CCYD/8bbbc/KiCad project/8bit-computer/8bit-computer.kicad_pcb

## KiCad design KiCad project/8bit-computer/8bit-computer.kicad_pcb (2024-12-27)

Schematic: 8bit-computer.kicad_sch

Parts:
C1, C3, C5, C6, C7, C8, C9, C10, C11, C12, C13, C14, C15, C16, C17, C18, C19, C20, C21, C22, C23, C24, C25, C26, C27, C28, C29, C30, C31, C32, C33, C34, C35, C36, C37, C38, C39, C40, C41, C42, C43, C44, C45, C46, C47, C48, C51, C52, C53, C54, C55, C56, C57, C60, C61, C63, C64, C65, C66, C67, C68, C69, C70: 0.1uF; C_Disc_D5.0mm_W2.5mm_P5.00mm
C2, C4: 1uF; C_Disc_D5.0mm_W2.5mm_P5.00mm
C49, C50: .01u; C_Disc_D5.0mm_W2.5mm_P5.00mm
C58, C59: 4.7u; CP_Radial_D8.0mm_P2.50mm
C62: 1u; C_Disc_D5.0mm_W2.5mm_P5.00mm
D1, D2, D3, D4, D7, D8, D9, D10, D11, D12, D13, D14, D17, D18, D19, D20, D21, D22, D23, D24, D25, D29, D30, D31, D32, D33, D34, D35, D36, D37, D39, D40, D41, D42, D43, D44, D45, D46, D47, D48, D49, D50, D51, D52, D53, D54, D55, D56, D57, D58, D59, D60, D61, D62, D63, D64, D69, D70, D71, D72, D73, D74, D75, D76, D77, D78, D79, D80, D81, D82, D83, D84, D85, D86, D87, D88, D89, D90, D91, D92, D93: LED; LED_D5.0mm
D5: Green; LED_D5.0mm
D6: Red; LED_D5.0mm
D15: 5817; D_A-405_P7.62mm_Horizontal
D16, D65, D66, D67, D68: Yellow; LED_D5.0mm
D26, D27, D28, D38: LED; LED_D5.0mm; not fitted
H1, H2, H3, H4, H5, H6: MountingHole_Pad; MountingHole_2.7mm_M2.5_DIN965_Pad
IC1, IC2, IC3: AT28C16-15PI; DIP1550W56P254L3190H559Q24N; Mouser Part Number 556-AT28C16-15PI
J1: USB_C_Receptacle_PowerOnly_6P; USB_C_Receptacle_GCT_USB4085
JP1: Jumper_2_Open; PinHeader_1x02_P2.54mm_Vertical
R1, R5, R10, R31, R33, R36, R37, R59, R60, R61, R62, R63, R64, R65, R66, R85, R89, R90, R91, R95, R96: 1K; R_Axial_DIN0207_L6.3mm_D2.5mm_P10.16mm_Horizontal
R2, R3, R4, R9, R16, R17, R35: 10K; R_Axial_DIN0207_L6.3mm_D2.5mm_P10.16mm_Horizontal
R6: 470K; R_Axial_DIN0207_L6.3mm_D2.5mm_P10.16mm_Horizontal
R7, R8: 1M; R_Axial_DIN0207_L6.3mm_D2.5mm_P10.16mm_Horizontal
R15: 120R; R_Axial_DIN0207_L6.3mm_D2.5mm_P10.16mm_Horizontal
R18, R32, R94: R_Axial_DIN0207_L6.3mm_D2.5mm_P10.16mm_Horizontal
R34: R_US; R_Axial_DIN0207_L6.3mm_D2.5mm_P10.16mm_Horizontal
R50: 1K; R_Axial_DIN0207_L6.3mm_D2.5mm_P10.16mm_Horizontal; not fitted
R88: 20K; R_Axial_DIN0207_L6.3mm_D2.5mm_P10.16mm_Horizontal
R92, R93: 5.1K; R_Axial_DIN0207_L6.3mm_D2.5mm_P10.16mm_Horizontal
RN1, RN2, RN3, RN4, RN5, RN6, RN7, RN8, RN9, RN10, RN11: R_Network08_US; R_Array_SIP9
RN12, RN13, RN14, RN15: R_Network04_US; R_Array_SIP5
RV1: 1M; Potentiometer_Alpha_RD901F-40-00D_Single_Vertical_CircularH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
SW1, SW6, SW7: SW_Push; SW_PUSH-12mm
SW2: SW_DIP_x08; DIP-16_W7.62mm_LongPads
SW3: SW_DIP_x04; DIP-8_W7.62mm_LongPads
SW4, SW5, SW9: SW_DPDT_x2_Mine; SW_Push_2P2T_Toggle_CK_PVA2xxH1xxxxxxV2
U1, U2, U3, U52: NE555P; DIP-8_W7.62mm_Socket_LongPads
U4, U12, U13, U30, U31: 74LS04; DIP-14_W7.62mm_Socket_LongPads
U5, U45, U56: 74LS08; DIP-14_W7.62mm_Socket_LongPads
U6: 74LS32; DIP-14_W7.62mm_Socket_LongPads
U7, U25, U26, U35, U36, U37, U39, U46, U57, U58: 74LS173; DIP-16_W7.62mm_Socket_LongPads
U8, U9, U15, U16, U17, U18, U19: 74LS157; DIP-16_W7.62mm_Socket_LongPads
U10, U11: 74F189PC; DIP-16_W7.62mm_Socket_LongPads
U14, U27, U32, U34, U38, U47: 74LS245; DIP-20_W7.62mm_Socket_LongPads
U20, U21: 74LS595; DIP-16_W7.62mm_Socket_LongPads
U22: NodeMCU_v1.0
U23, U24: 74LS00; DIP-14_W7.62mm_Socket_LongPads
U28, U33: 74LS161; DIP-16_W7.62mm_Socket_LongPads
U29: 74LS138; DIP-16_W7.62mm_Socket_LongPads
U40, U41: 74LS283; DIP-16_W7.62mm_Socket_LongPads
U42, U43: 74LS86; DIP-14_W7.62mm_Socket_LongPads
U44: 74LS02; DIP-14_W7.62mm_Socket_LongPads
U48, U49, U50, U51: D168K; D1X8K
U53: 74LS107; DIP-14_W7.62mm_Socket_LongPads
U55: 74LS139; DIP-16_W7.62mm_Socket_LongPads

Connections:
/A: IC3.16 (I/O6), U48.7 (A), U49.7 (A), U50.7 (A), U51.7 (A)
/A0: D26.2 (A), IC1.8 (A0), IC2.8 (A0), U28.14 (Q0), U29.1 (A0)
/A1: D27.2 (A), IC1.7 (A1), IC2.7 (A1), U28.13 (Q1), U29.2 (A1)
/A2: D28.2 (A), IC1.6 (A2), IC2.6 (A2), U28.12 (Q2), U29.3 (A2)
/A4: D22.2 (A), IC1.5 (A3), IC2.5 (A3), U25.3 (Q0)
/A5: D23.2 (A), IC1.4 (A4), IC2.4 (A4), U25.4 (Q1)
/A6: D24.2 (A), IC1.3 (A5), IC2.3 (A5), U25.5 (Q2)
/A7: D25.2 (A), IC1.2 (A6), IC2.2 (A6), U25.6 (Q3)
/B: IC3.15 (I/O5), U48.6 (B), U49.6 (B), U50.6 (B), U51.6 (B)
/BUS_0: D70.2 (A), RN2.2 (R1), U7.14 (D0), U14.18 (B0), U18.2 (I0a), U26.14 (D0), U27.18 (B0), U32.2 (A0), U33.3 (D0), U34.18 (B0), U35.14 (D0), U37.14 (D0), U38.18 (B0), U47.18 (B0), U58.14 (D0)
/BUS_1: D71.2 (A), RN2.3 (R2), U7.13 (D1), U14.17 (B1), U18.5 (I0b), U26.13 (D1), U27.17 (B1), U32.3 (A1), U33.4 (D1), U34.17 (B1), U35.13 (D1), U37.13 (D1), U38.17 (B1), U47.17 (B1), U58.13 (D1)
/BUS_2: D72.2 (A), RN2.4 (R3), U7.12 (D2), U14.16 (B2), U18.11 (I0c), U26.12 (D2), U27.16 (B2), U32.4 (A2), U33.5 (D2), U34.16 (B2), U35.12 (D2), U37.12 (D2), U38.16 (B2), U47.16 (B2), U58.12 (D2)
/BUS_3: D73.2 (A), RN2.5 (R4), U7.11 (D3), U14.15 (B3), U18.14 (I0d), U26.11 (D3), U27.15 (B3), U32.5 (A3), U33.6 (D3), U34.15 (B3), U35.11 (D3), U37.11 (D3), U38.15 (B3), U47.15 (B3), U58.11 (D3)
/BUS_4: D74.2 (A), RN2.6 (R5), U14.14 (B4), U19.2 (I0a), U25.14 (D0), U27.14 (B4), U34.14 (B4), U36.14 (D0), U38.14 (B4), U39.14 (D0), U47.14 (B4), U57.14 (D0)
/BUS_5: D75.2 (A), RN2.7 (R6), U14.13 (B5), U19.5 (I0b), U25.13 (D1), U27.13 (B5), U34.13 (B5), U36.13 (D1), U38.13 (B5), U39.13 (D1), U47.13 (B5), U57.13 (D1)
/BUS_6: D76.2 (A), RN2.8 (R7), U14.12 (B6), U19.11 (I0c), U25.12 (D2), U27.12 (B6), U34.12 (B6), U36.12 (D2), U38.12 (B6), U39.12 (D2), U47.12 (B6), U57.12 (D2)
/BUS_7: D77.2 (A), RN2.9 (R8), U14.11 (B7), U19.14 (I0d), U25.11 (D3), U27.11 (B7), U34.11 (B7), U36.11 (D3), U38.11 (B7), U39.11 (D3), U47.11 (B7), U57.11 (D3)
/C: IC3.14 (I/O4), U48.4 (C), U49.4 (C), U50.4 (C), U51.4 (C)
/CARRY: U41.9 (C4), U46.14 (D0)
/D: IC3.13 (I/O3), U48.2 (D), U49.2 (D), U50.2 (D), U51.2 (D)
/DP: IC3.17 (I/O7), U48.5 (DP), U49.5 (DP), U50.5 (DP), U51.5 (DP)
/E: IC3.11 (I/O2), U48.1 (E), U49.1 (E), U50.1 (E), U51.1 (E)
/F: IC3.9 (I/O0), U48.9 (F), U49.9 (F), U50.9 (F), U51.9 (F)
/G: IC3.10 (I/O1), U48.10 (G), U49.10 (G), U50.10 (G), U51.10 (G)
/IR_A0: D18.2 (A), U26.3 (Q0), U27.2 (A0)
/IR_A1: D19.2 (A), U26.4 (Q1), U27.3 (A1)
/IR_A2: D20.2 (A), U26.5 (Q2), U27.4 (A2)
/IR_A3: D21.2 (A), U26.6 (Q3), U27.5 (A3)
/ZERO: U45.8, U46.13 (D1)
/a0: D65.2 (A), RN13.3 (R2), U9.4 (Za), U10.1 (A0), U11.1 (A0)
/a1: D66.2 (A), RN13.2 (R1), U9.7 (Zb), U10.15 (A1), U11.15 (A1)
/a2: D67.2 (A), RN13.5 (R4), U9.9 (Zc), U10.14 (A2), U11.14 (A2)
/a3: D68.2 (A), RN13.4 (R3), U9.12 (Zd), U10.13 (A3), U11.13 (A3)
/a_d0: D49.2 (A), U34.2 (A0), U35.3 (Q0), U40.5 (A1)
/a_d1: D50.2 (A), U34.3 (A1), U35.4 (Q1), U40.3 (A2)
/a_d2: D51.2 (A), U34.4 (A2), U35.5 (Q2), U40.14 (A3)
/a_d3: D52.2 (A), U34.5 (A3), U35.6 (Q3), U40.12 (A4)
/a_d4: D53.2 (A), U34.6 (A4), U36.3 (Q0), U41.5 (A1)
/a_d5: D54.2 (A), U34.7 (A5), U36.4 (Q1), U41.3 (A2)
/a_d6: D55.2 (A), U34.8 (A6), U36.5 (Q2), U41.14 (A3)
/a_d7: D56.2 (A), U34.9 (A7), U36.6 (Q3), U41.12 (A4)
/b_d0: D57.2 (A), U37.3 (Q0), U38.2 (A0), U42.2
/b_d1: D58.2 (A), U37.4 (Q1), U38.3 (A1), U42.5
/b_d2: D59.2 (A), U37.5 (Q2), U38.4 (A2), U42.10
/b_d3: D60.2 (A), U37.6 (Q3), U38.5 (A3), U42.13
/b_d4: D61.2 (A), U38.6 (A4), U39.3 (Q0), U43.2
/b_d5: D62.2 (A), U38.7 (A5), U39.4 (Q1), U43.5
/b_d6: D63.2 (A), U38.8 (A6), U39.5 (Q2), U43.10
/b_d7: D64.2 (A), U38.9 (A7), U39.6 (Q3), U43.13
/d0: U10.4 (D0), U16.4 (Za)
/d1: U10.6 (D1), U16.7 (Zb)
/d2: U10.10 (D2), U16.9 (Zc)
/d3: U10.12 (D3), U16.12 (Zd)
/d4: U11.4 (D0), U17.4 (Za)
/d5: U11.6 (D1), U17.7 (Zb)
/d6: U11.10 (D2), U17.9 (Zc)
/d7: U11.12 (D3), U17.12 (Zd)
ARD_HALT: R10.2, U6.4, U22.20 (D8)
ARD_MAR_INP_SEL: R31.2, U9.1 (S), U22.22 (D6)
ARD_MA_A0: U9.3 (I1a), U21.3 (QD)
ARD_MA_A1: U9.6 (I1b), U21.2 (QC)
ARD_MA_A2: U9.10 (I1c), U21.1 (QB)
ARD_MA_A3: U9.13 (I1d), U21.15 (QA)
ARD_RAM_D0: U16.3 (I1a), U20.7 (QH)
ARD_RAM_D1: U16.6 (I1b), U20.6 (QG)
ARD_RAM_D2: U16.10 (I1c), U20.5 (QF)
ARD_RAM_D3: U16.13 (I1d), U20.4 (QE)
ARD_RAM_D4: U17.3 (I1a), U20.3 (QD)
ARD_RAM_D5: U17.6 (I1b), U20.2 (QC)
ARD_RAM_D6: U17.10 (I1c), U20.1 (QB)
ARD_RAM_D7: U17.13 (I1d), U20.15 (QA)
ARD_RAM_INP_SEL: D16.2 (A), R34.2, U16.1 (S), U17.1 (S), U22.21 (D7)
ARD_RAM_WR_EN: R18.1, U10.3 (*WE), U11.3 (*WE), U15.12 (Zd), U22.27 (D3)
ARD_RESET: R36.1, SW7.2, U22.23 (D5), U23.12, U23.13
CLK: D4.2 (A), U4.13, U5.8, U7.7 (Cp), U24.12, U24.13, U25.7 (Cp), U26.7 (Cp), U33.2 (CP), U35.7 (Cp), U36.7 (Cp), U37.7 (Cp), U39.7 (Cp), U46.7 (Cp), U56.1
GND: C1.2, C2.2, C3.2, C4.2, C5.2, C6.2, C7.1, C8.1, C9.1, C10.1, C11.1, C12.1, C13.1, C14.1, C15.1, C16.1, C17.1, C18.1, C19.1, C21.1, C22.1, C23.1, C24.1, C25.1, C26.1, C27.1, C28.1, C29.1, C30.1, C31.1, C32.2, C33.2, C34.1, C35.1, C36.1, C37.1, C38.1, C39.1, C40.1, C41.1, C42.1, C43.1, C44.1, C45.1, C46.1, C47.1, C48.1, C49.2, C50.2, C51.1, C52.2, C53.2, C54.1, C55.1, C56.1, C57.2, C58.2, C59.2, C60.1, C61.2, C62.2, C63.1, C64.1, C65.1, C66.1, C67.1, C68.1, C69.1, C70.1, H1.1, H2.1, H3.1, H4.1, H5.1, H6.1, IC1.1 (A7), IC1.12 (GND), IC1.18 (~CE), IC1.19 (A10), IC1.20 (~OE), IC2.12 (GND), IC2.18 (~CE), IC2.19 (A10), IC2.20 (~OE), IC3.12 (GND), IC3.18 (~CE), IC3.20 (~OE), J1.A12 (GND), J1.B12 (GND), J1.S1 (SHIELD), R2.2, R3.2, R4.1, R9.2, R10.1, R31.1, R33.2, R34.1, R35.2, R36.2, R37.2, R50.2, R65.2, R66.2, R89.2, R92.1, R93.1, R94.1, R95.2, RN2.1 (common), RN3.1 (common), RN4.1 (common), RN5.1 (common), RN6.1 (common), RN7.1 (common), RN8.1 (common), RN9.1 (common), RN10.1 (common), RN11.1 (common), RN13.1 (common), RN14.1 (common), RN15.1 (common), RV1.MP (MountPin), SW1.1, SW2.1, SW2.2, SW2.3, SW2.4, SW2.5, SW2.6, SW2.7, SW2.8, SW3.1, SW3.2, SW3.3, SW3.4, SW4.1 (A), SW5.1 (A), SW6.1, SW9.2 (C), U1.1 (GND), U2.1 (GND), U3.1 (GND), U3.6 (THR), U4.7 (GND), U5.7 (GND), U6.7 (GND), U7.1 (Oe1), U7.2 (Oe2), U7.8 (GND), U8.8 (GND), U8.15 (E), U9.8 (GND), U9.15 (E), U10.2 (*CS), U10.8 (GND), U11.2 (*CS), U11.8 (GND), U12.7 (GND), U13.7 (GND), U14.10 (GND), U15.8 (GND), U15.15 (E), U16.8 (GND), U16.15 (E), U17.8 (GND), U17.15 (E), U18.8 (GND), U18.15 (E), U19.8 (GND), U19.15 (E), U20.8 (GND), U21.8 (GND), U22.10 (GND), U22.14 (GND), U22.17 (GND), U22.24 (GND), U23.7 (GND), U24.7 (GND), U25.1 (Oe1), U25.2 (Oe2), U25.8 (GND), U26.1 (Oe1), U26.2 (Oe2), U26.8 (GND), U27.6 (A4), U27.7 (A5), U27.8 (A6), U27.9 (A7), U27.10 (GND), U28.8 (GND), U29.4 (E1), U29.5 (E2), U29.8 (GND), U30.7 (GND), U31.7 (GND), U32.1 (A->B), U32.10 (GND), U33.8 (GND), U34.10 (GND), U35.1 (Oe1), U35.2 (Oe2), U35.8 (GND), U36.1 (Oe1), U36.2 (Oe2), U36.8 (GND), U37.1 (Oe1), U37.2 (Oe2), U37.8 (GND), U38.10 (GND), U39.1 (Oe1), U39.2 (Oe2), U39.8 (GND), U40.8 (GND), U41.8 (GND), U42.7 (GND), U43.7 (GND), U44.7 (GND), U45.7 (GND), U46.1 (Oe1), U46.2 (Oe2), U46.8 (GND), U46.11 (D3), U46.12 (D2), U47.10 (GND), U52.1 (GND), U53.7 (GND), U55.1 (E), U55.8 (GND), U56.7 (GND), U57.1 (Oe1), U57.2 (Oe2), U57.8 (GND), U57.9 (E1), U57.10 (E2), U58.1 (Oe1), U58.2 (Oe2), U58.8 (GND), U58.9 (E1), U58.10 (E2)
HALT: D78.2 (A), IC1.17 (I/O7), U6.5
JC_FLAG: D47.2 (A), IC1.23 (A8), IC2.23 (A8), U46.3 (Q0)
JZ_FLAG: D48.2 (A), IC1.22 (A9), IC2.22 (A9), U46.4 (Q1)
unnamed: C20.1, R37.1, U24.1
unnamed: C20.2, U24.8
unnamed: D1.2 (A), U1.3 (Q), U5.2
unnamed: D1.1 (K), R2.1
unnamed: D2.2 (A), U2.3 (Q), U5.5
unnamed: D2.1 (K), R3.1
unnamed: D3.2 (A), R8.2, U3.3 (Q), U4.1, U5.1
unnamed: D3.1 (K), R4.2
unnamed: D4.1 (K), R9.1
unnamed: D5.2 (A), R16.2
unnamed: D5.1 (K), SW4.3 (B)
unnamed: D6.2 (A), R17.2
unnamed: D6.1 (K), R15.2, SW4.2 (C), U8.1 (S), U15.1 (S), U24.4, U24.5
unnamed: D7.2 (A), U12.2, U14.2 (A0)
unnamed: D7.1 (K), RN5.2 (R1)
unnamed: D8.2 (A), U12.4, U14.3 (A1)
unnamed: D8.1 (K), RN5.3 (R2)
unnamed: D9.2 (A), U12.6, U14.4 (A2)
unnamed: D9.1 (K), RN5.4 (R3)
unnamed: D10.2 (A), U12.8, U14.5 (A3)
unnamed: D10.1 (K), RN5.5 (R4)
unnamed: D11.2 (A), U12.10, U14.6 (A4)
unnamed: D11.1 (K), RN5.6 (R5)
unnamed: D12.2 (A), U12.12, U14.7 (A5)
unnamed: D12.1 (K), RN5.7 (R6)
unnamed: D13.2 (A), U13.2, U14.8 (A6)
unnamed: D13.1 (K), RN5.8 (R7)
unnamed: D14.2 (A), U13.4, U14.9 (A7)
unnamed: D14.1 (K), RN5.9 (R8)
unnamed: D15.1 (K), U22.15 (VIN)
unnamed: D16.1 (K), R33.1
unnamed: D17.2 (A), U4.9, U6.6
unnamed: D17.1 (K), R35.1
unnamed: D18.1 (K), RN3.2 (R1)
unnamed: D19.1 (K), RN3.3 (R2)
unnamed: D20.1 (K), RN3.4 (R3)
unnamed: D21.1 (K), RN3.5 (R4)
unnamed: D22.1 (K), RN3.6 (R5)
unnamed: D23.1 (K), RN3.7 (R6)
unnamed: D24.1 (K), RN3.8 (R7)
unnamed: D25.1 (K), RN3.9 (R8)
unnamed: D26.1 (K), RN11.9 (R8)
unnamed: D27.1 (K), RN11.8 (R7)
unnamed: D28.1 (K), RN11.7 (R6)
unnamed: D29.2 (A), U29.15 (O0)
unnamed: D29.1 (K), RN11.2 (R1)
unnamed: D30.2 (A), U29.14 (O1)
unnamed: D30.1 (K), RN11.3 (R2)
unnamed: D31.2 (A), U29.13 (O2)
unnamed: D31.1 (K), RN11.4 (R3)
unnamed: D32.2 (A), U29.12 (O3)
unnamed: D32.1 (K), RN11.5 (R4)
unnamed: D33.2 (A), U29.11 (O4)
unnamed: D33.1 (K), RN11.6 (R5)
unnamed: D34.2 (A), U32.18 (B0), U33.14 (Q0)
unnamed: D34.1 (K), RN15.2 (R1)
unnamed: D35.2 (A), U32.17 (B1), U33.13 (Q1)
unnamed: D35.1 (K), RN15.3 (R2)
unnamed: D36.2 (A), U32.16 (B2), U33.12 (Q2)
unnamed: D36.1 (K), RN15.4 (R3)
unnamed: D37.2 (A), U32.15 (B3), U33.11 (Q3)
unnamed: D37.1 (K), RN15.5 (R4)
unnamed: D38.2 (A), U22.4 (SD3)
unnamed: D38.1 (K), R50.1
unnamed: D39.2 (A), U40.4 (S1), U44.12, U47.2 (A0)
unnamed: D39.1 (K), RN6.2 (R1)
unnamed: D40.2 (A), U40.1 (S2), U44.11, U47.3 (A1)
unnamed: D40.1 (K), RN6.3 (R2)
unnamed: D41.2 (A), U40.13 (S3), U44.9, U47.4 (A2)
unnamed: D41.1 (K), RN6.4 (R3)
unnamed: D42.2 (A), U40.10 (S4), U44.8, U47.5 (A3)
unnamed: D42.1 (K), RN6.5 (R4)
unnamed: D43.2 (A), U41.4 (S1), U44.6, U47.6 (A4)
unnamed: D43.1 (K), RN6.6 (R5)
unnamed: D44.2 (A), U41.1 (S2), U44.5, U47.7 (A5)
unnamed: D44.1 (K), RN6.7 (R6)
unnamed: D45.2 (A), U41.13 (S3), U44.3, U47.8 (A6)
unnamed: D45.1 (K), RN6.8 (R7)
unnamed: D46.2 (A), U41.10 (S4), U44.2, U47.9 (A7)
unnamed: D46.1 (K), RN6.9 (R8)
unnamed: D47.1 (K), R65.1
unnamed: D48.1 (K), R66.1
unnamed: D49.1 (K), RN8.2 (R1)
unnamed: D50.1 (K), RN8.3 (R2)
unnamed: D51.1 (K), RN8.4 (R3)
unnamed: D52.1 (K), RN8.5 (R4)
unnamed: D53.1 (K), RN8.6 (R5)
unnamed: D54.1 (K), RN8.7 (R6)
unnamed: D55.1 (K), RN8.8 (R7)
unnamed: D56.1 (K), RN8.9 (R8)
unnamed: D57.1 (K), RN7.2 (R1)
unnamed: D58.1 (K), RN7.3 (R2)
unnamed: D59.1 (K), RN7.4 (R3)
unnamed: D60.1 (K), RN7.5 (R4)
unnamed: D61.1 (K), RN7.6 (R5)
unnamed: D62.1 (K), RN7.7 (R6)
unnamed: D63.1 (K), RN7.8 (R7)
unnamed: D64.1 (K), RN7.9 (R8)
unnamed: D65.1 (K), RN14.5 (R4)
unnamed: D66.1 (K), RN14.4 (R3)
unnamed: D67.1 (K), RN14.3 (R2)
unnamed: D68.1 (K), RN14.2 (R1)
unnamed: D69.1 (K), R94.2
unnamed: D70.1 (K), RN4.2 (R1)
unnamed: D71.1 (K), RN4.3 (R2)
unnamed: D72.1 (K), RN4.4 (R3)
unnamed: D73.1 (K), RN4.5 (R4)
unnamed: D74.1 (K), RN4.6 (R5)
unnamed: D75.1 (K), RN4.7 (R6)
unnamed: D76.1 (K), RN4.8 (R7)
unnamed: D77.1 (K), RN4.9 (R8)
unnamed: D78.1 (K), RN9.2 (R1)
unnamed: D79.2 (A), IC1.16 (I/O6), U30.1
unnamed: D79.1 (K), RN9.3 (R2)
unnamed: D80.1 (K), RN9.4 (R3)
unnamed: D81.2 (A), IC1.14 (I/O4), U30.3
unnamed: D81.1 (K), RN9.5 (R4)
unnamed: D82.2 (A), IC1.13 (I/O3), U30.5
unnamed: D82.1 (K), RN9.6 (R5)
unnamed: D83.2 (A), IC1.11 (I/O2), U30.13
unnamed: D83.1 (K), RN9.7 (R6)
unnamed: D84.2 (A), IC1.9 (I/O0), U30.9
unnamed: D84.1 (K), RN9.8 (R7)
unnamed: D85.2 (A), IC1.10 (I/O1), U30.11
unnamed: D85.1 (K), RN9.9 (R8)
unnamed: D86.2 (A), IC2.17 (I/O7), U31.1
unnamed: D86.1 (K), RN10.2 (R1)
unnamed: D87.1 (K), RN10.3 (R2)
unnamed: D88.2 (A), IC2.15 (I/O5), U31.3
unnamed: D88.1 (K), RN10.4 (R3)
unnamed: D89.1 (K), RN10.5 (R4)
unnamed: D90.2 (A), IC2.11 (I/O2), U31.13
unnamed: D90.1 (K), RN10.6 (R5)
unnamed: D91.1 (K), RN10.7 (R6)
unnamed: D92.2 (A), IC2.10 (I/O1), U31.11
unnamed: D92.1 (K), RN10.8 (R7)
unnamed: D93.2 (A), IC2.9 (I/O0), U31.5
unnamed: D93.1 (K), RN10.9 (R8)
unnamed: IC3.8 (A0), U58.3 (Q0)
unnamed: IC3.7 (A1), U58.4 (Q1)
unnamed: IC3.6 (A2), U58.5 (Q2)
unnamed: IC3.5 (A3), U58.6 (Q3)
unnamed: IC3.4 (A4), U57.3 (Q0)
unnamed: IC3.3 (A5), U57.4 (Q1)
unnamed: IC3.2 (A6), U57.5 (Q2)
unnamed: IC3.1 (A7), U57.6 (Q3)
unnamed: IC3.23 (A8), U53.2 (~Q), U53.9 (C), U55.2 (A0)
unnamed: IC3.22 (A9), U53.5 (Q), U55.3 (A1)
unnamed: IC3.19 (A10), JP1.1 (A), R89.1
unnamed: J1.A5 (CC1), R93.2
unnamed: J1.B5 (CC2), R92.2
unnamed: R59.1, U45.12, U45.13
unnamed: R60.2, U5.12, U5.13
unnamed: R61.2, U4.3, U4.5, U4.11
unnamed: R62.2, U6.9, U6.10, U6.12, U6.13
unnamed: R63.1, U13.5, U13.9, U13.11, U13.13
unnamed: R64.1, U31.9
unnamed: R91.1, U56.4, U56.5, U56.9, U56.10, U56.12, U56.13
unnamed: R96.2, RV1.3
unnamed: RN1.2 (R1), SW2.16, U18.3 (I1a)
unnamed: RN1.3 (R2), SW2.15, U18.6 (I1b)
unnamed: RN1.4 (R3), SW2.14, U18.10 (I1c)
unnamed: RN1.5 (R4), SW2.13, U18.13 (I1d)
unnamed: RN1.6 (R5), SW2.12, U19.3 (I1a)
unnamed: RN1.7 (R6), SW2.11, U19.6 (I1b)
unnamed: RN1.8 (R7), SW2.10, U19.10 (I1c)
unnamed: RN1.9 (R8), SW2.9, U19.13 (I1d)
unnamed: RN12.2 (R1), SW3.8, U8.11 (I0c)
unnamed: RN12.3 (R2), SW3.7, U8.14 (I0d)
unnamed: RN12.4 (R3), SW3.6, U8.5 (I0b)
unnamed: RN12.5 (R4), SW3.5, U8.2 (I0a)
unnamed: SW5.3 (B), U3.4 (R)
unnamed: R7.2, SW5.2 (C), U3.2 (TR)
unnamed: SW9.3 (B), U22.26 (D4)
unnamed: C1.1, U1.5 (CV)
unnamed: R1.1, R96.1, U1.7 (DIS)
unnamed: C2.1, RV1.2, U1.2 (TR), U1.6 (THR)
unnamed: C3.1, U2.5 (CV)
unnamed: C4.1, R6.2, U2.6 (THR), U2.7 (DIS)
unnamed: C6.1, R5.2, SW1.2, U2.2 (TR)
unnamed: C5.1, U3.5 (CV)
unnamed: U4.2, U5.4
unnamed: U4.8, U5.10
unnamed: U5.3, U6.1
unnamed: U5.6, U6.2
unnamed: U5.9, U6.3
unnamed: U7.3 (Q0), U8.3 (I1a)
unnamed: U7.4 (Q1), U8.6 (I1b)
unnamed: U7.5 (Q2), U8.10 (I1c)
unnamed: U7.6 (Q3), U8.13 (I1d)
unnamed: U8.4 (Za), U9.2 (I0a)
unnamed: U8.7 (Zb), U9.5 (I0b)
unnamed: U8.9 (Zc), U9.11 (I0c)
unnamed: U8.12 (Zd), U9.14 (I0d)
unnamed: U10.5 (*O0), U12.1
unnamed: U10.7 (*O1), U12.3
unnamed: U10.9 (*O2), U12.5
unnamed: U10.11 (*O3), U12.9
unnamed: U11.5 (*O0), U12.11
unnamed: U11.7 (*O1), U12.13
unnamed: U11.9 (*O2), U13.1
unnamed: U11.11 (*O3), U13.3
unnamed: C13.2, R32.2, SW6.2, U15.14 (I0d)
unnamed: U15.13 (I1d), U24.3
unnamed: U16.2 (I0a), U18.4 (Za)
unnamed: U16.5 (I0b), U18.7 (Zb)
unnamed: U16.11 (I0c), U18.9 (Zc)
unnamed: U16.14 (I0d), U18.12 (Zd)
unnamed: U17.2 (I0a), U19.4 (Za)
unnamed: U17.5 (I0b), U19.7 (Zb)
unnamed: U17.11 (I0c), U19.9 (Zc)
unnamed: U17.14 (I0d), U19.12 (Zd)
unnamed: U18.1 (S), U19.1 (S), U24.6
unnamed: U20.9 (QH'), U21.14 (SER)
unnamed: C62.1, U20.12 (RCLK), U21.12 (RCLK), U22.29 (D1)
unnamed: U20.14 (SER), U22.30 (D0)
unnamed: U20.11 (SRCLK), U21.11 (SRCLK), U22.28 (D2)
unnamed: R95.1, U20.13 (~OE), U21.13 (~OE)
unnamed: U23.3, U23.4, U23.5
unnamed: U24.9, U24.10, U24.11
unnamed: U23.6, U28.1 (~MR)
unnamed: U23.2, U29.10 (O5)
unnamed: U40.6 (B1), U42.3
unnamed: U40.2 (B2), U42.6
unnamed: U40.15 (B3), U42.8
unnamed: U40.11 (B4), U42.11
unnamed: U40.9 (C4), U41.7 (C0)
unnamed: U41.6 (B1), U43.3
unnamed: U41.2 (B2), U43.6
unnamed: U41.15 (B3), U43.8
unnamed: U41.11 (B4), U43.11
unnamed: U44.1, U45.1
unnamed: U44.4, U45.2
unnamed: U44.10, U45.4
unnamed: U44.13, U45.5
unnamed: U45.3, U45.9
unnamed: U45.6, U45.10
unnamed: C50.1, U52.5 (CV)
unnamed: R85.2, R88.2, U52.7 (DIS)
unnamed: U52.3 (Q), U53.12 (C)
unnamed: C49.1, R88.1, U52.2 (TR), U52.6 (THR)
unnamed: U48.3 (CC), U48.8 (CC), U55.4 (O0)
unnamed: U49.3 (CC), U49.8 (CC), U55.5 (O1)
unnamed: U50.3 (CC), U50.8 (CC), U55.6 (O2)
unnamed: U51.3 (CC), U51.8 (CC), U55.7 (O3)
unnamed: R90.2, U55.13 (A1), U55.14 (A0)
unnamed: U56.3, U57.7 (Cp), U58.7 (Cp)
OUTPUT_IN: D89.2 (A), IC2.14 (I/O4), U56.2
PC_EN: D91.2 (A), IC2.13 (I/O3), U33.7 (CEP), U33.10 (CET)
RAM_IN: D80.2 (A), IC1.15 (I/O5), U24.2
RESET: U7.15 (Mr), U23.8, U25.15 (Mr), U26.15 (Mr), U35.15 (Mr), U36.15 (Mr), U37.15 (Mr), U39.15 (Mr), U46.15 (Mr), U57.15 (Mr), U58.15 (Mr)
SUBTRACT: D87.2 (A), IC2.16 (I/O6), U40.7 (C0), U42.1, U42.4, U42.9, U42.12, U43.1, U43.4, U43.9, U43.12
VCC: C7.2, C8.2, C9.2, C10.2, C11.2, C12.2, C14.2, C15.2, C16.2, C17.2, C18.2, C19.2, C21.2, C22.2, C23.2, C24.2, C25.2, C26.2, C27.2, C28.2, C29.2, C30.2, C31.2, C32.1, C33.1, C34.2, C35.2, C36.2, C37.2, C38.2, C39.2, C40.2, C41.2, C42.2, C43.2, C44.2, C45.2, C46.2, C47.2, C48.2, C51.2, C52.1, C53.1, C54.2, C55.2, C56.2, C57.1, C58.1, C59.1, C60.2, C61.1, C63.2, C64.2, C65.2, C66.2, C67.2, C68.2, C69.2, C70.2, D15.2 (A), D69.2 (A), IC1.21 (~WE), IC1.24 (VCC), IC2.1 (A7), IC2.21 (~WE), IC2.24 (VCC), IC3.21 (~WE), IC3.24 (VCC), J1.A9 (VBUS), J1.B9 (VBUS), JP1.2 (B), R1.2, R5.1, R6.1, R7.1, R8.1, R15.1, R16.1, R17.1, R18.2, R32.1, R59.2, R60.1, R61.1, R62.1, R63.2, R64.2, R85.1, R90.1, R91.2, RN1.1 (common), RN12.1 (common), SW7.1, SW9.1 (A), U1.8 (VCC), U2.8 (VCC), U3.8 (VCC), U4.14 (VCC), U5.14 (VCC), U6.14 (VCC), U7.16 (VCC), U8.16 (VCC), U9.16 (VCC), U10.16 (VCC), U11.16 (VCC), U12.14 (VCC), U13.14 (VCC), U14.1 (A->B), U14.20 (VCC), U15.2 (I0a), U15.3 (I1a), U15.5 (I0b), U15.6 (I1b), U15.10 (I1c), U15.11 (I0c), U15.16 (VCC), U16.16 (VCC), U17.16 (VCC), U18.16 (VCC), U19.16 (VCC), U20.10 (~SRCLR), U20.16 (VCC), U21.10 (~SRCLR), U21.16 (VCC), U23.14 (VCC), U24.14 (VCC), U25.16 (VCC), U26.16 (VCC), U27.1 (A->B), U27.20 (VCC), U28.3 (D0), U28.4 (D1), U28.5 (D2), U28.6 (D3), U28.7 (CEP), U28.9 (~PE), U28.16 (VCC), U29.6 (E3), U29.16 (VCC), U30.14 (VCC), U31.14 (VCC), U32.20 (VCC), U33.16 (VCC), U34.1 (A->B), U34.20 (VCC), U35.16 (VCC), U36.16 (VCC), U37.16 (VCC), U38.1 (A->B), U38.19 (CE), U38.20 (VCC), U39.16 (VCC), U40.16 (VCC), U41.16 (VCC), U42.14 (VCC), U43.14 (VCC), U44.14 (VCC), U45.14 (VCC), U46.16 (VCC), U47.1 (A->B), U47.20 (VCC), U52.8 (VCC), U53.1 (J), U53.4 (K), U53.8 (J), U53.10 (~R), U53.11 (K), U53.13 (~R), U53.14 (VCC), U55.15 (E), U55.16 (VCC), U56.14 (VCC), U57.16 (VCC), U58.16 (VCC)
~A_REG_IN: U30.8, U35.9 (E1), U35.10 (E2), U36.9 (E1), U36.10 (E2)
~A_REG_OUT: U30.10, U34.19 (CE)
~B_REG_IN: U31.4, U37.9 (E1), U37.10 (E2), U39.9 (E1), U39.10 (E2)
~CLK: U4.12, U28.2 (CP)
~FLAG_IN: U31.6, U46.9 (E1), U46.10 (E2)
~IR_IN: U25.9 (E1), U25.10 (E2), U26.9 (E1), U26.10 (E2), U30.12
~IR_OUT: U27.19 (CE), U30.6
~JUMP: U31.10, U33.9 (~PE)
~MAR_IN: U7.9 (E1), U7.10 (E2), U30.2
~PC_OUT: U31.12, U32.19 (CE)
~RAM_OUT: U14.19 (CE), U30.4
~RESET: U23.1, U23.9, U23.10, U23.11, U33.1 (~MR)
~SUM_OUT: U31.2, U47.19 (CE)

Notes on the sheet:
RESISTORS FOR LEDS: RED: 1K GREEN: 4.7k BLUE: 1K YELLOW: 470k Swap 1K for 4.7K if too bright.
NOTE: D0 is LSB . . D7 is MSB
Memory and Memory Address Register
Step - Binary
Reset Circuit
Instruction - Decimal (visually)
Right (Ard)
Extra Register
A/B Registers and Arithmetic Logic Unit
Control Logic
Program Counter
Clock Module
Instruction
TODO: Review this switch
Left (Switches)
Set ESP Wifi Mode (Station vs AP Mode)
TODO: reorganize address and data lines according to bus
1K resistors probably? Had an issue with the HALT voltage dropping too low.
Wifi Mode Indicator

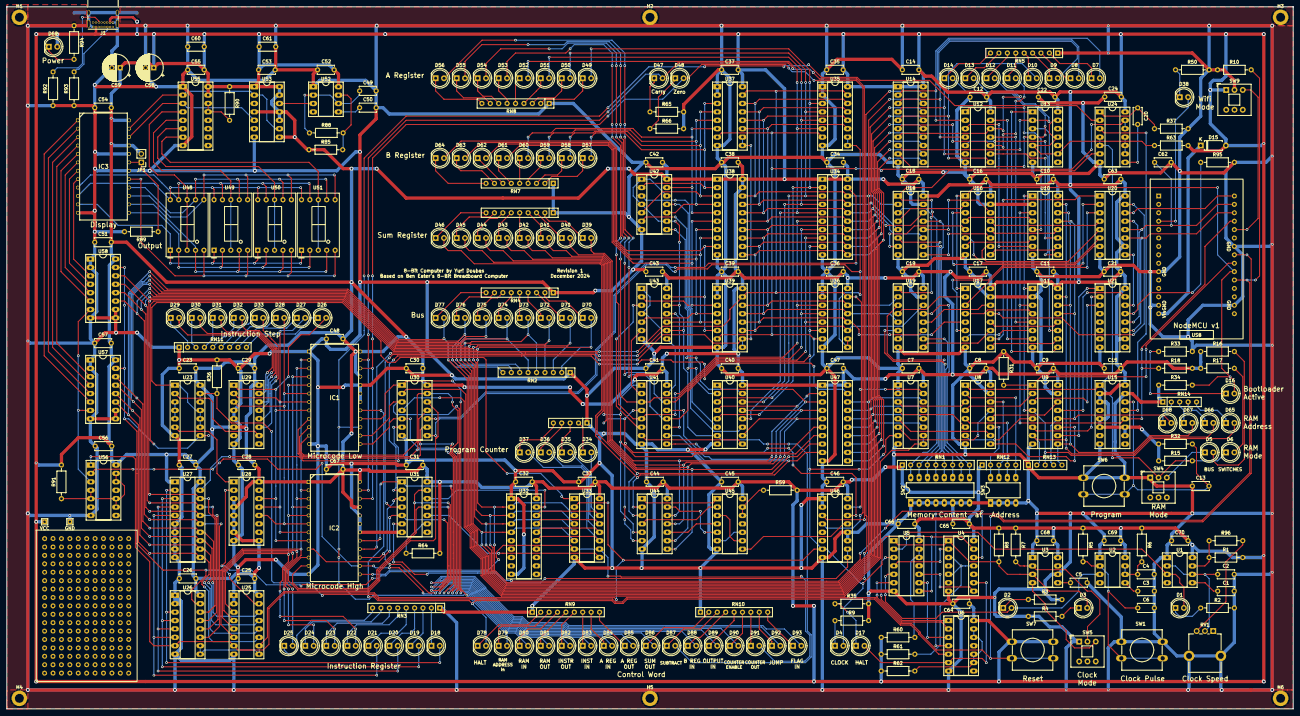
[picture p1: board 8bit-computer.kicad_pcb from above]

Board: 4 copper layers, 388.6 x 212.1 mm, 295 parts (0 on the bottom side), 345 nets.
